LeeMakeKR/Self_Balancing_Device/pics/스크린샷 2026-06-23 111240.png

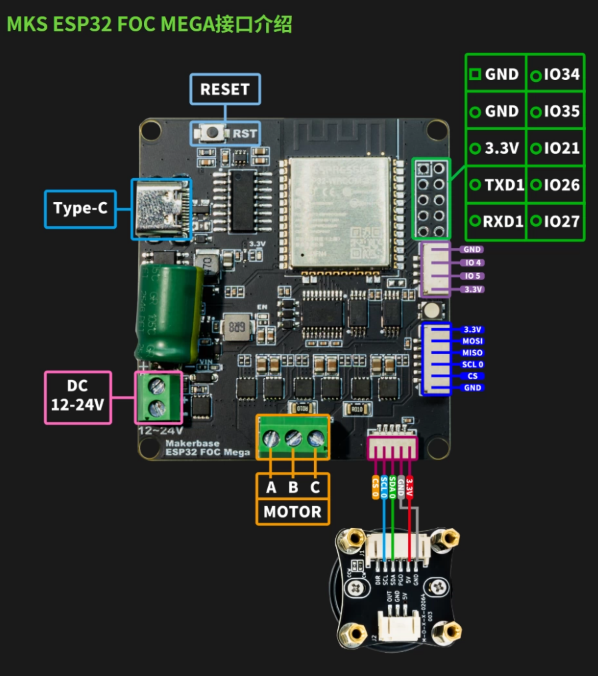
pics/스크린샷 2026-06-23 111240.png
