LeeMakeKR/Self_Balancing_Device/pics/nidec24h055m020.jpg

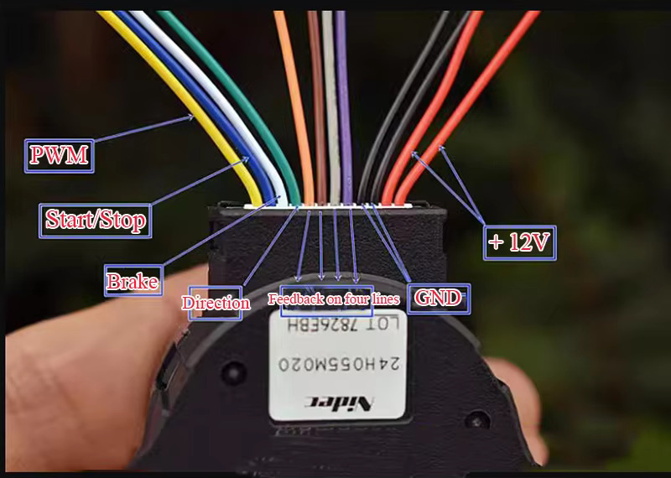
pics/nidec24h055m020.jpg
