LeeMakeKR/Self_Balancing_Device/제작 로그.md

# 제작 로그

## 20260718

esp32 foc 보드 테스트 및 점검. mks esp32 foc 보드와 dengfoc 보드 배선이 동일함을 확인.

- mega 보드의 enable 핀은 GPIO12(중요)
- 3720 bldc 모터(안마건용)은 3800rpm이 한계로 파악됨
- 2808 bldc 모터(RC용)는 4500rpm 이상 회전 가능함을 확인. 하지만 발열 문제가 있고 볼트축으로 고정하는 구조라 밸런스휠의 단단한 고정이 힘듦
- ProDrone 4212 모터로 결정
- esp32 foc 각 보드는 모터 제어용으로만 사용하고, 메인 esp32 보드가 can 통신으로 각 모터를 제어. 그리고 IMU 6개도 메인보드에 배치된다.

## 20260724

- 자이로센서의 배치 최적화

## 20260731

- 1축 조립하여 테스트하고, can 연결하여 메인보드가 개별축을 컨트롤하는 구조 테스트 에정
- 1축에서는 as5047을 이용하여 모터의 회전과 각도를 확인하고, 모터의 회전을 높여가면서 최대 rpm 확인.
- 브레이크가 영 해결이 안됨. 일단 자이로만 제작하고 브레이크는 나중에 추가할까?

## 20260807

- **결정: IMU는 ICM-42688-P를 기본, MPU-6500을 대안으로 확정.** 둘 다 TDK InvenSense 제품이고 SPI 배선·핀 배정이 동일해 서로 교체해도 하드웨어 변경 없음. 상세는 [README.md](../README.md)의 「IMU 센서 선정」 참고.
- IMU SPI 핀 배정 정정: MISO=GPIO4, MOSI=GPIO5, SCK=GPIO6.
- 테스트 스케치 작성: [TestCode/06_imu_test](../TestCode/06_imu_test/06_imu_test.ino). 외부 라이브러리 없이 레지스터 직접 접근으로 동작하며, `WHO_AM_I`(0x75) 값으로 두 기종을 자동 판별함(ICM-42688-P 0x47 / MPU-6500 0x70). 자이로 바이어스 측정 기능 포함.

## 모터 특성 측정 결과

1축 프로토타입의 반작용 휠 구동계 실측 기록입니다. 측정에 쓴 스케치는 [TestCode/02_ramp_tuning](../TestCode/02_ramp_tuning/02_ramp_tuning.ino) 입니다.

### 가속률(램프율) 한계 측정 — 2026-07-31

| 지령 [RPM/s] | t95 [ms] | 실제 달성 [RPM/s] | 추종 여부 |
| --- | --- | --- | --- |
| 200 | 14043 | 203 | 지령대로 |
| 320 | 8784 | 324 | 지령대로 |
| 512 | 5493 | 519 | 지령대로 |
| 819 | 3462 | 823 | 지령대로 |
| **1311** | **2166** | **1316** | **한계 지점** |
| 2097 | 2239 | 1273 | 포화 |
| 3355 | 2180 | 1307 | 포화 |
| 5369 | 2152 | 1324 | 포화 |
| 8590 | 2236 | 1275 | 포화 |

1311 RPM/s까지는 지령과 실제가 일치하고, 그 위로는 실제값이 **1275~1324 RPM/s**에
고정됩니다. 지령을 6배(8590)로 올려도 도달 시간이 줄지 않는다는 것은
전압/토크 한계에 걸렸다는 뜻입니다.

```text
최대 각가속도  α_max ≈ 1320 RPM/s ≈ 138 rad/s²
권장 지령 램프율      1311 RPM/s  (한계의 99%, 추종 유지)
```

권장값이 물리적 한계와 1% 이내로 일치하므로 **추가 튜닝의 실익이 없습니다.**
스윕을 더 촘촘히 해도 t95는 15ms 정도만 줄어듭니다.

### 제어 설계에 미치는 의미

1. 반작용 휠이 낼 수 있는 최대 토크가 `τ_max = J_wheel × 138 [rad/s²]` 로 묶입니다.
   J_wheel(휠 관성모멘트)을 별도로 구하면 τ_max가 절대값으로 확정됩니다.
2. 이 값은 0 → 2850 RPM 구간의 **평균**입니다. `TorqueControlType::voltage`에서는
   속도가 오를수록 역기전력이 인가전압을 잠식해 가용 토크가 줄어듭니다.
   저속에서는 138보다 크고, 고속에서는 작습니다.

## 20260807

bmi270 센서 테스트. 타오바오산 센서의 문제로 icm-42688-p 센서로 교체. 이 센서는 너무 고가라
mpu 6500 센서로 대체할 예정

## 20260901
 
 nidec 24h055m020 모터 데이터 수집

 https://www.instructables.com/Reverse-Engineering-the-Nidec-24H055M020-Encoder-S/
 
 ## 20260916
Nidec 24h055m020 모터 테스트. Nidec.md 문서 참조.
