LeeMakeKR/Self_Balancing_Device/documents/회로설계.md

# 회로 설계

## 개요

본 프로젝트는 **SimpleFOC 라이브러리**를 기반으로 모터 제어 회로를 설계하였다. SimpleFOC 드라이버의 레퍼런스 디자인을 참조하여 회로를 구성하였으며, 고성능 필드 지향 제어(Field Oriented Control)를 구현하기 위한 하드웨어를 선정하였다.

## 주요 구성 요소

### 1. 모터 드라이버
- **DRV8313**: 3상 브러시리스 DC 모터 드라이버
  - 3개의 하프 브릿지 드라이버 내장
  - PWM 제어 방식
  - SimpleFOC 라이브러리와 호환

### 2. 전류 센서
- **INA240 x 3개**: 고정밀 전류 감지 증폭기
  - 각 상(Phase)별 전류 측정
  - 3개의 센서를 통한 3상 전류 모니터링
  - 실시간 전류 피드백을 통한 정밀 제어

### 3. 자기각 센서
- **AS5047P**: 고해상도 자기 엔코더
  - 14비트 분해능
  - SPI 통신 지원
  - 절대 각도 위치 측정
  - 모터 로터의 정확한 위치 피드백 제공

## 회로 구성

SimpleFOC 드라이버의 설계를 기반으로 DRV8313 모터 드라이버와 INA240 전류 센서 3개를 결합하여 통합 드라이버 회로를 구성하였다. AS5047P 자기각 센서는 모터의 정확한 위치 피드백을 제공하여 FOC 알고리즘의 정밀한 제어를 가능하게 한다.
