LeeMakeKR/Self_Balancing_Device/documents/수학적_이론.md

# 수학적 이론

# Cubli 논문 기반 수학 모델 정리

이 문서는 다음 두 논문의 수식과 가정을 기준으로 정리했다.

1. Gajamohan et al., The Cubli: A Cube that can Jump Up and Balance, IROS 2012.
2. Gajamohan et al., The Cubli: A Reaction Wheel Based 3D Inverted Pendulum.

아래 내용은 논문의 원식에 맞춘 모델이며, 임의의 단순화 모델(균질 정육면체 1휠 라그랑주 축약형)과 구분한다.

---

## 1. 2012 논문 기준: 1차원 프로토타입 모델

### 1.1 물리 구성

- 정사각 플레이트 형태의 pendulum body가 코너 축에서 회전한다.
- 중심에 반작용 휠 1개가 모터로 연결되어 있다.
- 상태 변수는 body 기울기와 body/휠 각속도를 사용한다.

### 1.2 변수 정의

- $\theta_b$: body 기울기 각
- $\theta_w$: 휠의 body 대비 회전 변위
- $\dot{\theta}_b, \dot{\theta}_w$: 각속도
- $u$: 모터 전류 입력
- $T_m = K_m u$: 모터 토크

### 1.3 비선형 동역학

논문 식 (1):

$$
\ddot{\theta}_b =
\frac{(m_b l_b + m_w l) g \sin\theta_b - T_m - C_b \dot{\theta}_b + C_w \dot{\theta}_w}
{I_b + m_w l^2}
$$

$$
\ddot{\theta}_w =
\frac{(I_b + I_w + m_w l^2)(T_m - C_w \dot{\theta}_w)}{I_w (I_b + m_w l^2)}
-
\frac{(m_b l_b + m_w l) g \sin\theta_b - C_b \dot{\theta}_b}{I_b + m_w l^2}
$$

여기서 파라미터 의미는 논문과 동일하다.

- $m_b, m_w$: body/휠 질량
- $I_b$: body의 피벗축 관성모멘트
- $I_w$: 휠+로터 관성모멘트
- $l, l_b$: 피벗 기준 거리
- $C_b, C_w$: 점성 마찰 계수

중요: 기존 문서의 $I=\frac{2}{3}ML^2$, $r=\frac{L}{\sqrt{2}}$ 같은 균질 정육면체 가정은 2012 논문의 1D 프로토타입 유도식과 직접적으로 일치하지 않는다.

### 1.4 선형화 상태공간

논문은 $(\theta_b, \dot{\theta}_b, \dot{\theta}_w)=(0,0,0)$ 근방에서 선형화하여

$$
\dot{x}(t)=Ax(t)+Bu(t), \quad x=[\theta_b,\dot{\theta}_b,\dot{\theta}_w]^T
$$

를 사용한다.

$$
A=
\begin{bmatrix}
0 & 1 & 0 \\
\frac{(m_b l_b+m_w l)g}{I_b+m_w l^2} & -\frac{C_b}{I_b+m_w l^2} & \frac{C_w}{I_b+m_w l^2} \\
-\frac{(m_b l_b+m_w l)g}{I_b+m_w l^2} & \frac{C_b}{I_b+m_w l^2} & -\frac{C_w(I_b+I_w+m_w l^2)}{I_w(I_b+m_w l^2)}
\end{bmatrix}
$$

$$
B=
\begin{bmatrix}
0 \\
-\frac{K_m}{I_b+m_w l^2} \\
\frac{K_m(I_b+I_w+m_w l^2)}{I_w(I_b+m_w l^2)}
\end{bmatrix}
$$

---

## 2. 3D Cubli 논문 기준: Kane 식 기반 모델

### 2.1 일반화 속도

$$
v := (\omega_h, \omega_{w1}, \omega_{w2}, \omega_{w3}) \in \mathbb{R}^6
$$

- $\omega_h \in \mathbb{R}^3$: 하우징의 각속도
- $\omega_{wi}$: 각 휠 축 각속도

### 2.2 비선형 운동방정식

논문 식 (16):

$$
\hat{\Theta}\,\dot{\omega}_h
=
\Theta\omega_h \times \omega_h
+ M g
+ \Theta_w \omega_w \times \omega_h
- (K_m u - C_w \omega_w)
$$

$$
\Theta_w \dot{\omega}_w
=
K_m u - C_w \omega_w - \Theta_w \dot{\omega}_h
$$

여기서

$$
M = m_h \tilde{r}_h + \sum_{i=1}^{3} m_w \tilde{r}_{wi},
\quad
\hat{\Theta} = \Theta - \Theta_w
$$

이며, 자세 운동학은 논문 식 (17)을 사용한다.

### 2.3 선형화 모델

평형점 $\phi_0$와 영각속도 근방에서 선형화하면 논문 식 (21)

$$
\begin{bmatrix}
\dot{\hat{\phi}} \\
\dot{\hat{\omega}}_h \\
\dot{\hat{\omega}}_w
\end{bmatrix}
=
A
\begin{bmatrix}
\hat{\phi} \\
\hat{\omega}_h \\
\hat{\omega}_w
\end{bmatrix}
+
\begin{bmatrix}
0_{3\times 3} \\
-\hat{\Theta}^{-1}K_m \\
(\hat{\Theta}^{-1}+\Theta_w^{-1})K_m
\end{bmatrix}
\hat{u}
$$

를 얻는다.

핵심 성질:

- yaw $\alpha$는 관측 불가 상태로 분리 가능
- 선형화 모델에는 비제어 모드가 존재하며, 논문은 좌표변환 후 제어가능 부분에 LQR을 적용

---

## 3. 상태추정(논문 일치 버전)

### 3.1 2012 (1D)

- 2개 가속도계를 body 대각선에 배치해 동적항을 상쇄하고 $\theta_b$를 추정
- 자이로와 홀센서로 $\dot{\theta}_b$, $\dot{\theta}_w$ 추정
- 저역통과 필터 상태를 추가해 tilt 오프셋을 자동 보정

### 3.2 3D

- 6개 IMU 중 가속도계 측정을 강체 기하 제약으로 결합
- 센서 위치 행렬 $P$로부터 미리 계산한 $\hat{X}=P^T(PP^T)^{-1}$를 사용
- 중력 벡터 추정: $\hat{B}_g = M\hat{X}(:,1)$

---

## 4. 제어 설계 포인트(논문 기준)

- 2012: 선형화 1D 모델에 대해 이산시간 LQR 적용
- 3D: 선형화 후 비제어 상태를 제거한 축소 모델에 LQR 적용
- 점프업은 고속 휠 제동 충격을 사용하고, 균형 근처에서 밸런싱 모드로 전환

---

## 5. 기존 문서 대비 수정된 핵심 오류

1. 균질 정육면체 단일 관성식($I=\frac{2}{3}ML^2$)을 기본식으로 둔 부분을 제거했다.
2. 단일 라그랑주 축약식 기반 비선형식 대신, 두 논문의 실제 식(2012 식 (1), 3D 식 (16), (21))으로 교체했다.
3. 3D 모델의 yaw 분리/비제어 모드 존재를 반영했다.
4. 참고문헌에서 첨부 논문과 무관한 항목(arXiv 반작용휠 펜듈럼)을 제거했다.

---

## 참고문헌

1. Mohanarajah Gajamohan, Michael Merz, Igor Thommen, Raffaello D'Andrea, The Cubli: A Cube that can Jump Up and Balance, IEEE/RSJ IROS 2012, pp. 3722-3727.
2. Mohanarajah Gajamohan, Michael Muehlebach, Tobias Widmer, Raffaello D'Andrea, The Cubli: A Reaction Wheel Based 3D Inverted Pendulum.
