LeeMakeKR/Self_Balancing_Device/pics/K-20251220-162317877.jpg

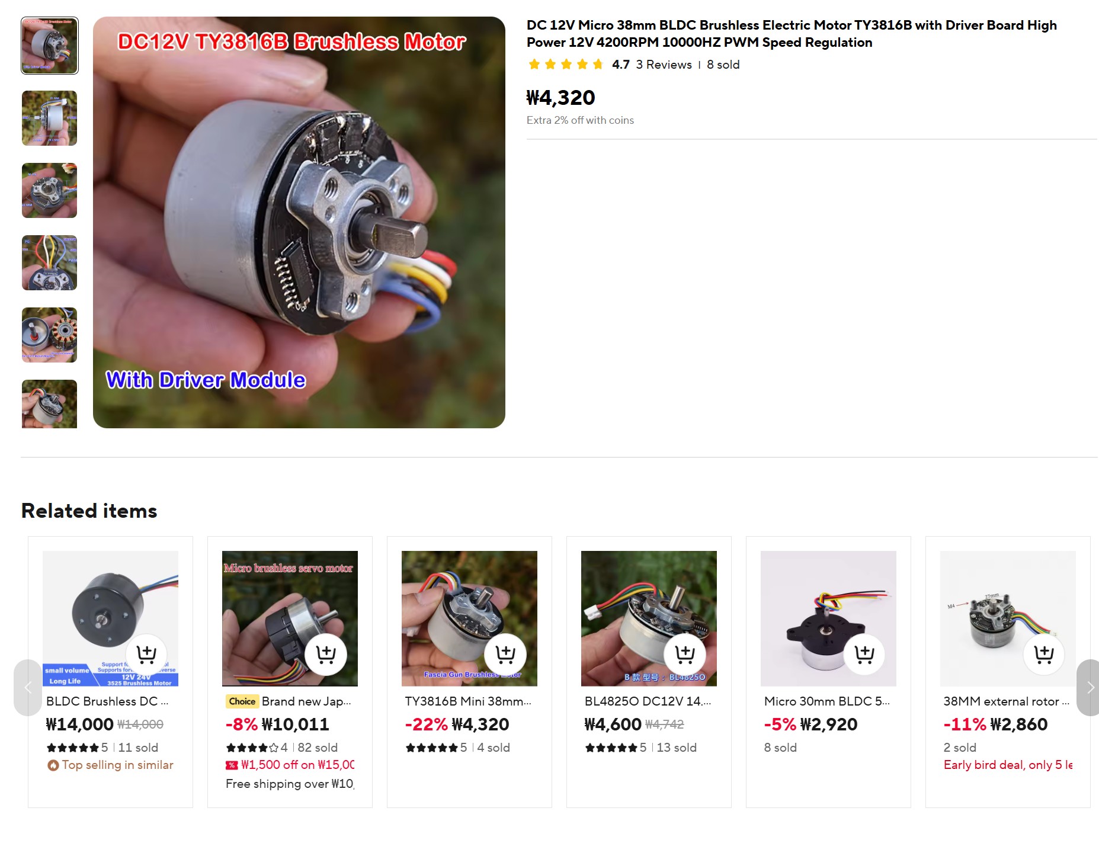
pics/K-20251220-162317877.jpg
