LeeMakeKR/Self_Balancing_Device/pics/xyzimages.jpg

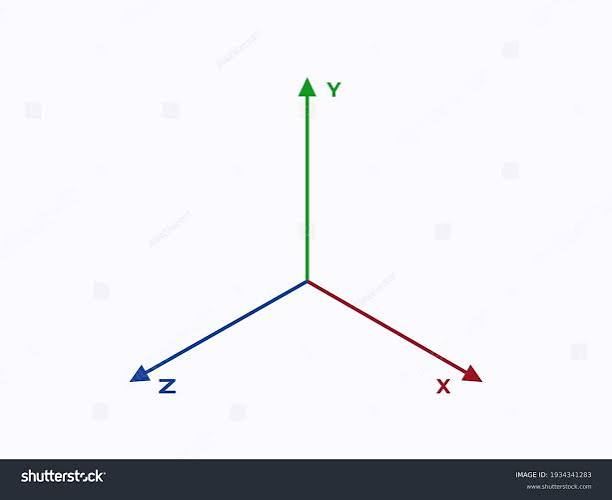
pics/xyzimages.jpg
