LeeMakeKR/Self_Balancing_Device/(commit log)

2025-11-21 README.md 및 제작 계획서 업데이트: 개발 단계 및 하드웨어 설계 세부사항 추가
2025-11-25 제작 계획서 파일 추가: 프로젝트 개요, 개발 단계 및 소프트웨어 아키텍처 포함
2025-12-20 Add LED fading example with PWM control
    - Implemented a new Arduino sketch to demonstrate LED fading using PWM on pin 13.
    - Configured additional pins for speed and direction control.
    - Added serial output for monitoring speed and direction changes.
    - Included delay for visual effect and direction reversal logic.
2025-12-23 제작 계획서에 모터 드라이버 및 센서 통신 관련 추가 정보 업데이트
2025-12-23 제작 계획서에 자이로 휠 및 센서 비용 관련 정보 추가
2026-01-02 README.md에 추가 링크 업데이트
2026-01-02 README.md에서 자이로 센서 및 모터 시스템 설명 수정, 수학적 이론 문서 추가
2026-01-03 Refactor motor control code and add sensor testing functionality
2026-01-18 Update 제작 계획서.md to clarify motor driver selection and component specifications
2026-02-02 가독성과 유지보수성 향상을 위한 코드 구조 리팩토링
2026-02-02 회로 설계 문서 추가 및 주요 구성 요소 설명
2026-02-03 문서 정리
2026-04-03 README.md에 코드 참조 링크 추가
2026-05-24 README.md에 서보를 이용한 브레이킹 메커니즘 참고 자료 추가
2026-06-08 AGENTS.md, CLAUDE.md, copilot-instructions.md 파일 추가 및 필수 참조 문서 링크 삽입
2026-07-07 Add AS5600 sensor example and create 제작 로그.md for documentation
    - Implemented a basic example for using the AS5600 magnetic sensor with ESP32-C3.
    - Initialized I2C communication with custom SDA and SCL pins.
    - Added a loop to read and display sensor angle and velocity.
    - Created a new 제작 로그.md file for project documentation.
    [rcmotor.odrivepreset.json]
2026-07-17 Add analysis documentation for MKS ESP32 FOC Mega board and troubleshooting steps
2026-07-18 모터 Enable/Disable 기능 추가 및 전압 제한 수정, 자동 하드웨어 진단 테스트 코드 추가
2026-07-18 Remove outdated MKS ESP32 FOC PCB documentation and update production log with testing notes for ESP32 FOC board, including wiring confirmation and motor specifications.
2026-07-29 Refactor: Remove test sketches and update documentation
    - Deleted test.ino and test_esp32c3_dengfoc.ino files as they are no longer needed.
    - Updated project documentation to reflect changes in motor control and sensor integration.
    - Added new structure document outlining the overall system flow and module logic for better clarity in development.
    - Revised sections on driver selection, IMU configuration, and control logic to align with current project requirements.
2026-07-31 Remove current RPM sweep test code, add direction and RPM measurement test, and implement ramp tuning test for speed control optimization.
2026-09-13 NIDEC 24H055M020 BLDC 모터 조사 자료 추가
